ishika859/basestation/code/Screenshot 2026-11-09 at 5.56.28 PM.png

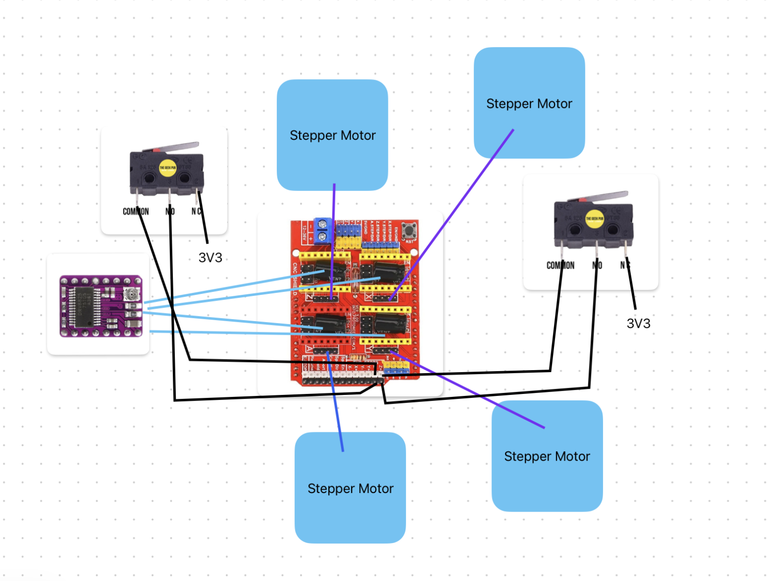
code/Screenshot 2026-11-09 at 5.56.28 PM.png
