ishika859/basestation/Cad/basestation.step

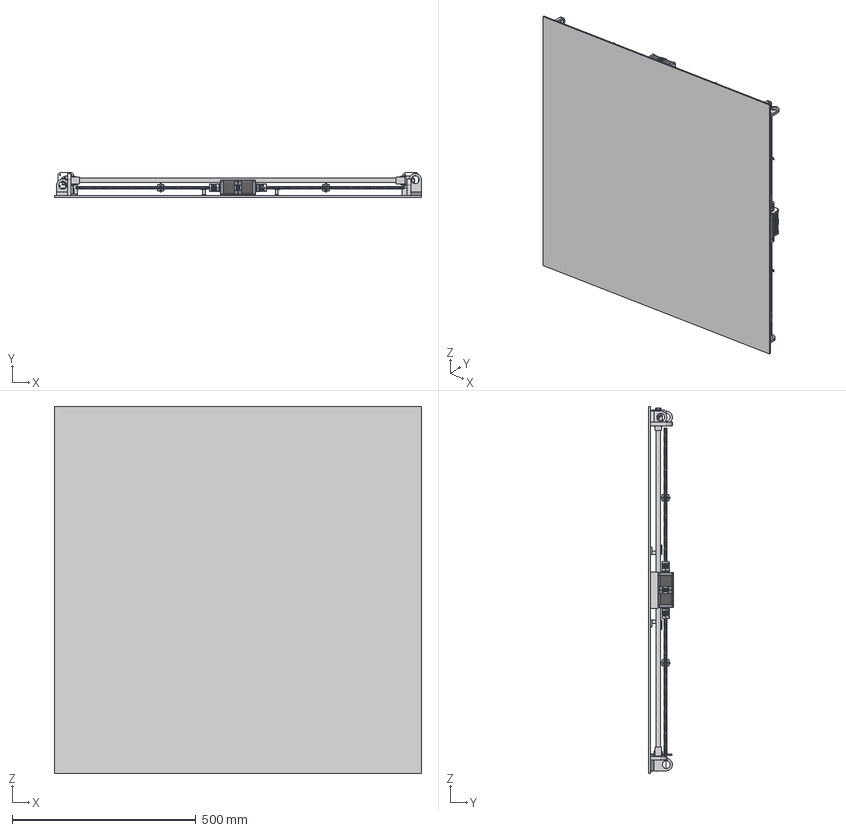
[picture p2: CAD file, 2026-11-09]
Cad/basestation.step
1000.0 x 67.0 x 1000.0 mm
