ishika859/basestation/Cad/printable/bearing rod holder.stl

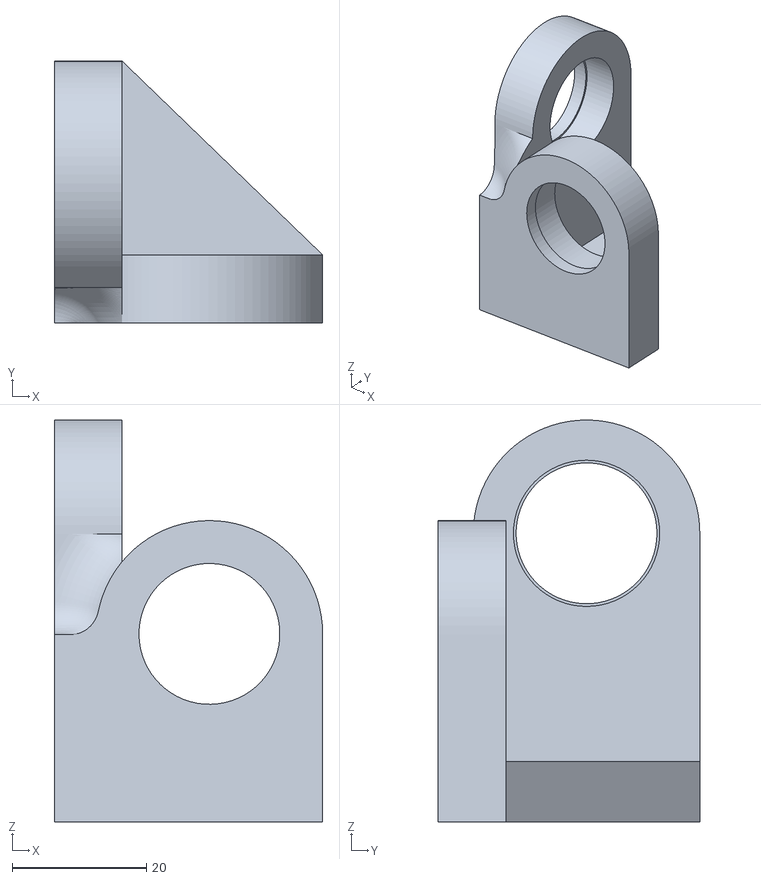
[picture p3: CAD file, 2026-11-09]
Cad/printable/bearing rod holder.stl
40.0 x 39.0 x 59.9
