ishika859/basestation/Cad/printable/small_lswitch.stl

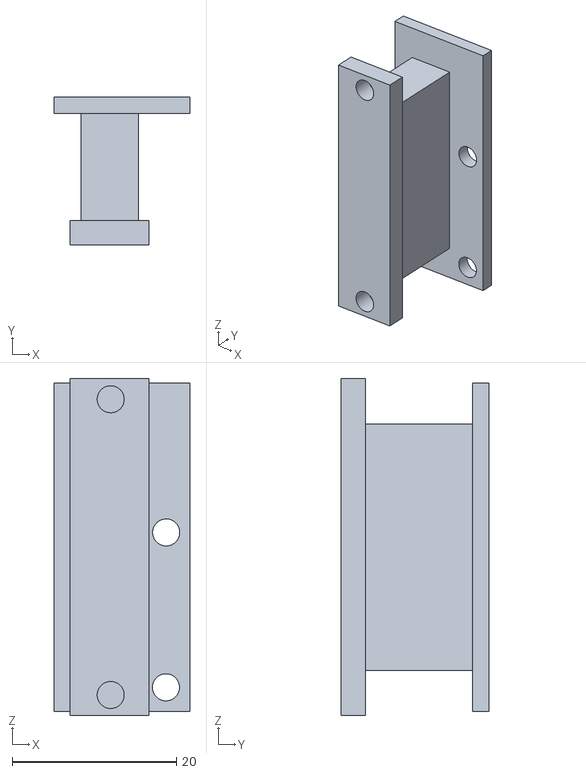
[picture p4: CAD file, 2026-11-09]
Cad/printable/small_lswitch.stl
16.5 x 18.0 x 41.0
