ishika859/basestation/Cad/printable/lswitch_mount.stl

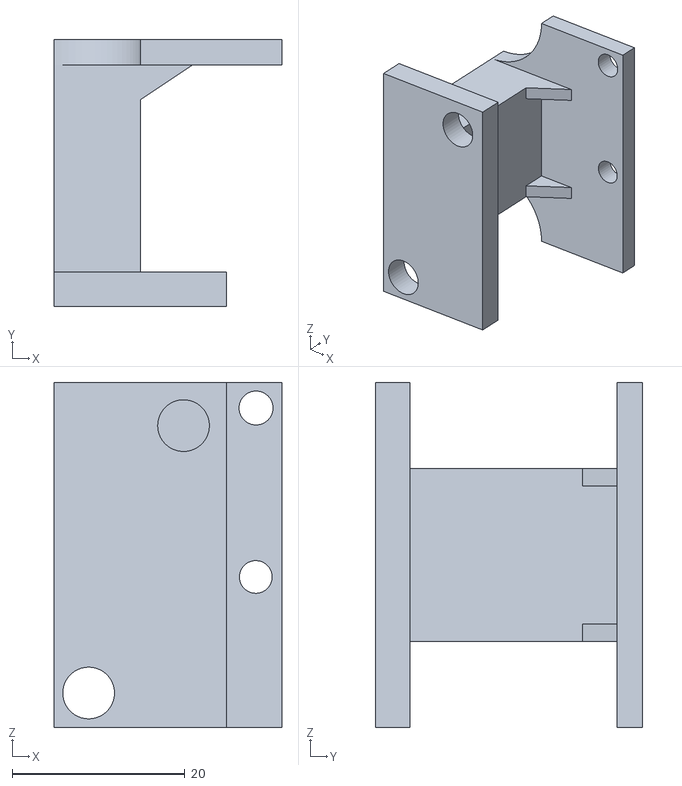
[picture p5: CAD file, 2026-11-09]
Cad/printable/lswitch_mount.stl
26.4 x 31.0 x 40.0
