ishika859/basestation/Cad/printable/rod mount.stl

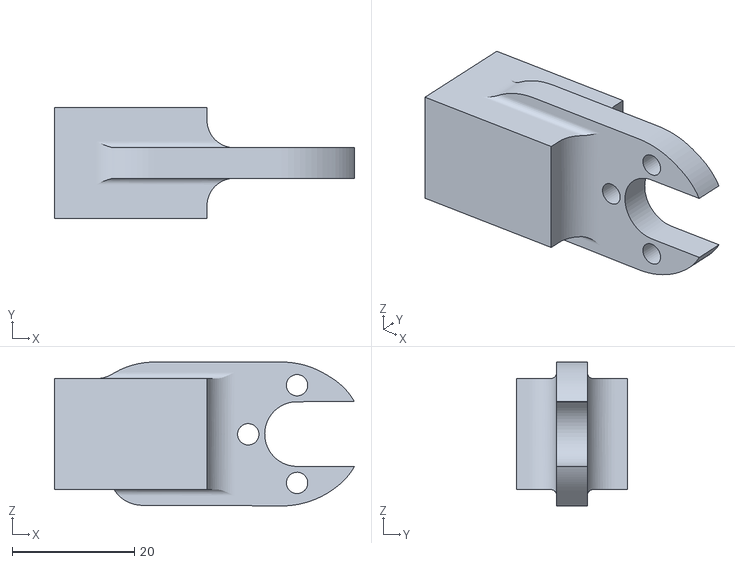
[picture p6: CAD file, 2026-11-09]
Cad/printable/rod mount.stl
49.2 x 18.2 x 23.6
