ishika859/basestation/Cad/printable/motor_rester.stl

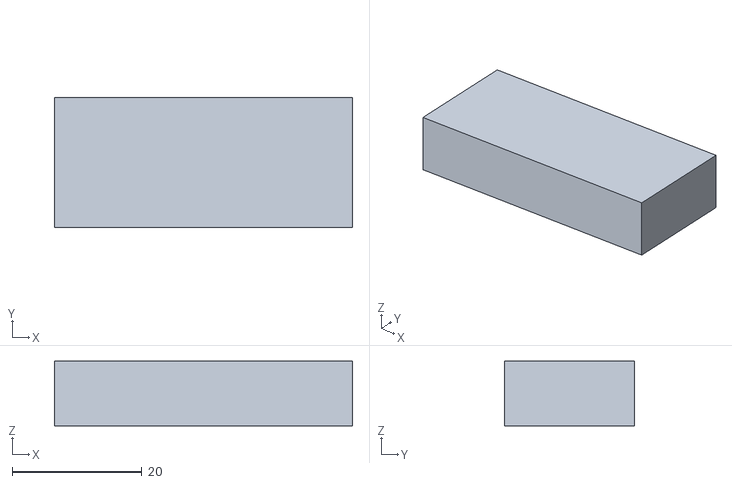
[picture p7: CAD file, 2026-11-09]
Cad/printable/motor_rester.stl
46.0 x 20.0 x 10.0
