ishika859/basestation/(list of files, cad)

Other CAD files:
Cad/basestation.f3z
